blark/6809sidecar/README.md

# 6809sidecar

This board is untested and experimental.
