blark/6809sidecar/3d/User Library-MINI-DIN-6.step

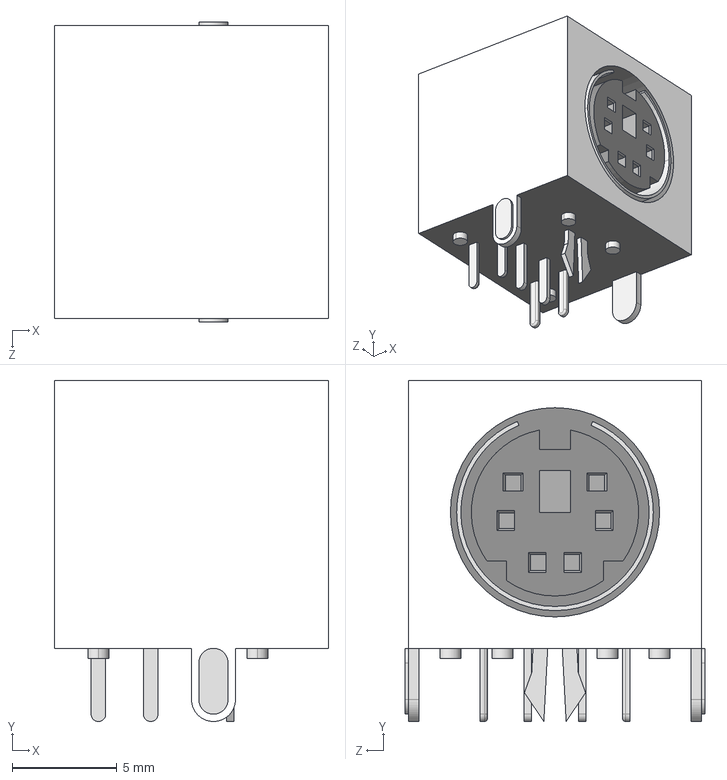
[picture p1: CAD file, 2023-02-28]
3d/User Library-MINI-DIN-6.step
13.1 x 16.3 x 14.3 mm
