blark/6809sidecar/3d/User Library-DPDT cod 2UD1T1A1M2RE.STEP

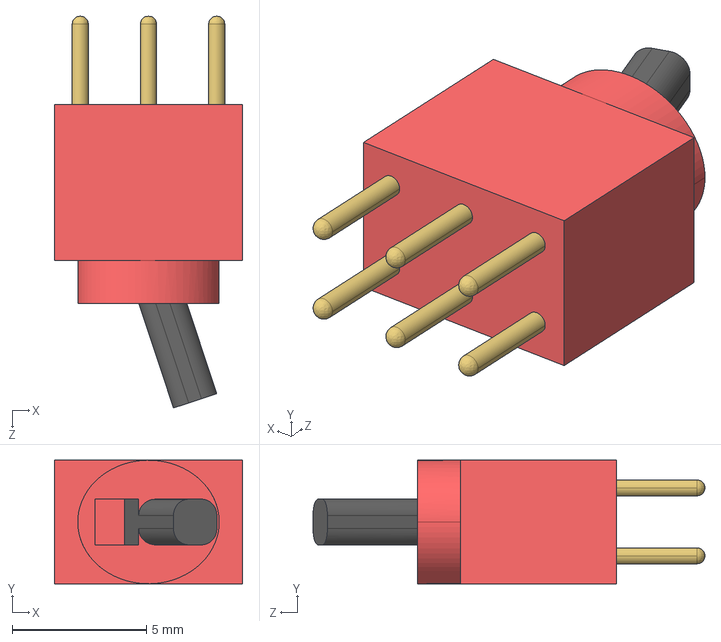
[picture p2: CAD file, 2023-02-28]
3d/User Library-DPDT cod 2UD1T1A1M2RE.STEP
7.00 x 4.60 x 14.6 mm
