blark/6809sidecar/3d/User Library-DIP-40P-M02.STEP

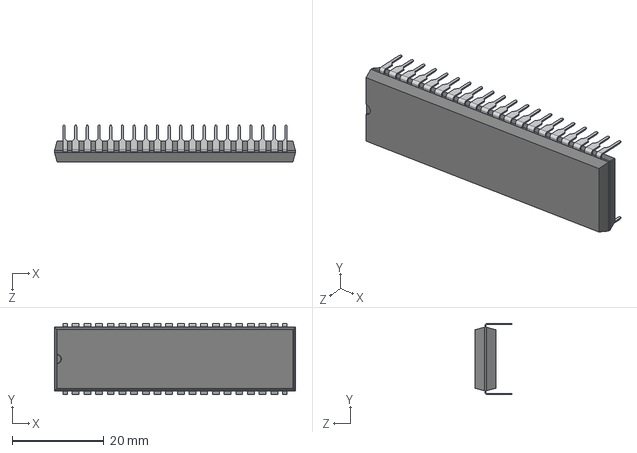
[picture p3: CAD file, 2023-01-27]
3d/User Library-DIP-40P-M02.STEP
52.4 x 15.5 x 8.00 mm
