blark/6809sidecar/3d/User Library-ic___40p.STEP

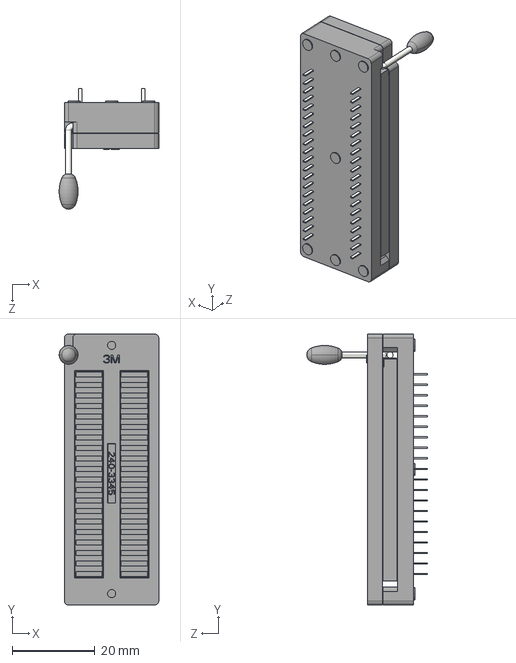
[picture p4: CAD file, 2023-01-27]
3d/User Library-ic___40p.STEP
24.1 x 65.5 x 29.1 mm
